maharjanalvik/ES1050-Winter-Project-2026-Lab-16-Pellets/Media/Pelletizer_with_electronics_enclosure.jpg

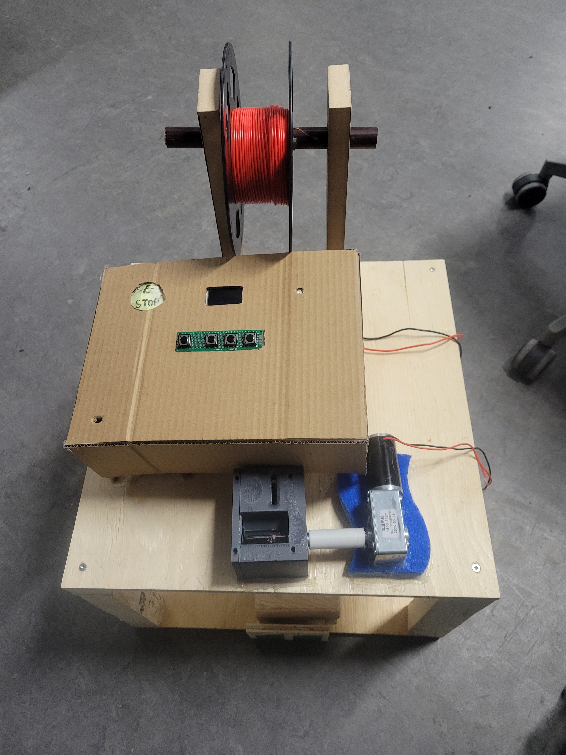
Media/Pelletizer_with_electronics_enclosure.jpg
