maharjanalvik/ES1050-Winter-Project-2026-Lab-16-Pellets/README.md

# Open-Source Recycled Plastic Pelletizer

A modular, open-source mechanical system designed to convert shredded plastic waste into uniform, high-quality pellets suitable for 3D printing and injection molding applications.

## Overview
This project is part of a larger closed-loop recycling workflow, enabling plastic waste to be processed into reusable material. The pelletizer focuses on consistency, reliability, and adaptability across different polymer types.

## Features
- **Open Source** Fully documented CAD models, technical drawings, and assembly instructions for easy replication and modification.

- **Modular Design** Components are designed for quick maintenance, repair, and upgrades without rebuilding the entire system.

- **Adjustable Processing** Supports variable speed and temperature control to accommodate a range of thermoplastics.

## Repository Structure
- `/CAD` → 3D models (STEP, STL) and technical drawings
- `/PelletizerFirmware` → Microcontroller firmware and control logic
- `/Electronics` → Wiring diagrams and circuit documentation
- `/Media` → Photos and videos of the system
- `BOM.csv` → Bill of Materials with sourcing link

## Getting Started
1. Review the **BOM.csv** to source required components  
2. Follow the assembly instructions in `/CAD` and `/Electronics`  
3. Upload firmware from `/Code` to the microcontroller  
4. Calibrate speed and temperature based on your material  

## Applications
- Pellet-based 3D printing  
- Injection molding  
- Plastic recycling research and prototyping  

## Acknowledgements
Developed for the FAST Lab at Western University under the supervision of Dr. Alessia Romani.  
Design inspiration referenced from [Teaching Tech](https://teachingtechyt.github.io/).
