maharjanalvik/ES1050-Winter-Project-2026-Lab-16-Pellets/Electronics/Block Diagram.png

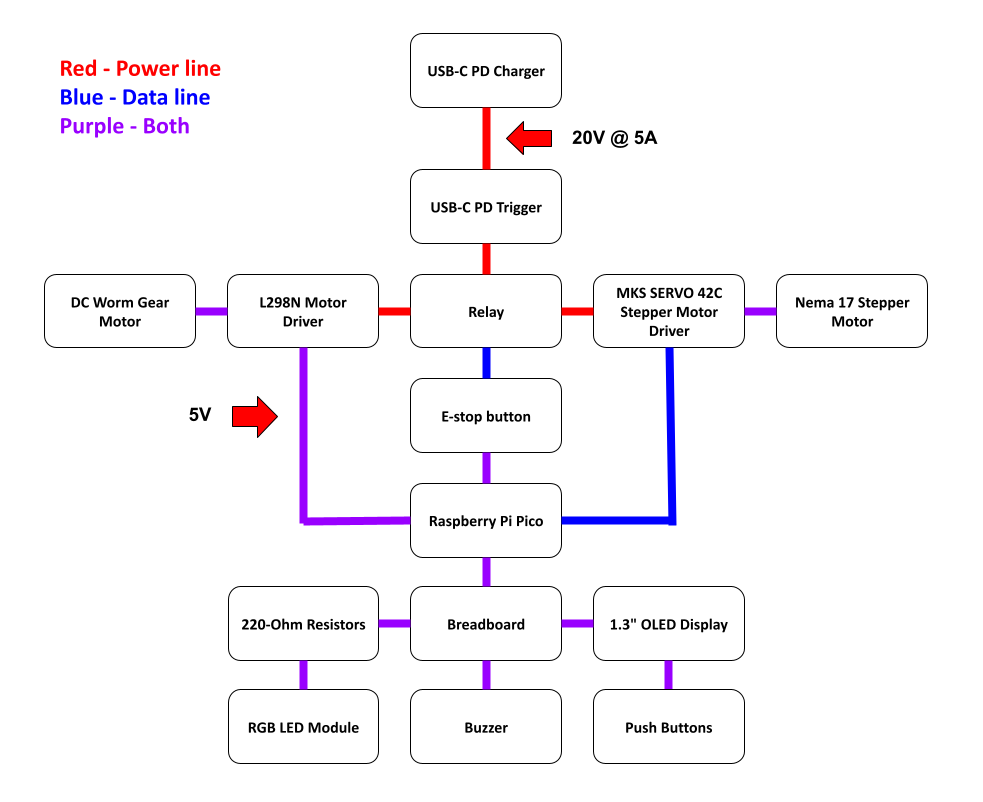
Electronics/Block Diagram.png
