maharjanalvik/ES1050-Winter-Project-2026-Lab-16-Pellets/Electronics/Schematic.png

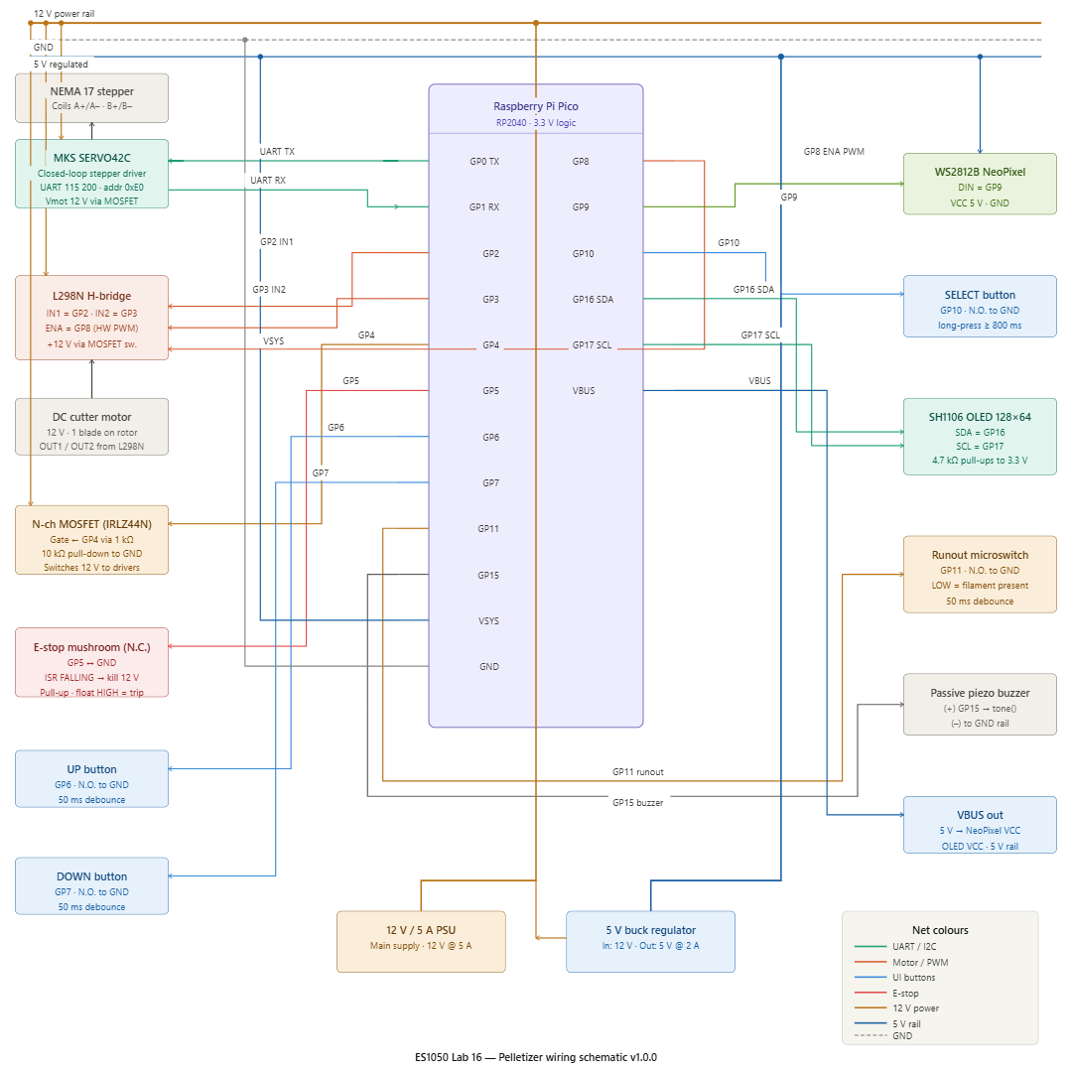
Electronics/Schematic.png
