maharjanalvik/ES1050-Winter-Project-2026-Lab-16-Pellets/Media/Sample_cut_pellets.jpg

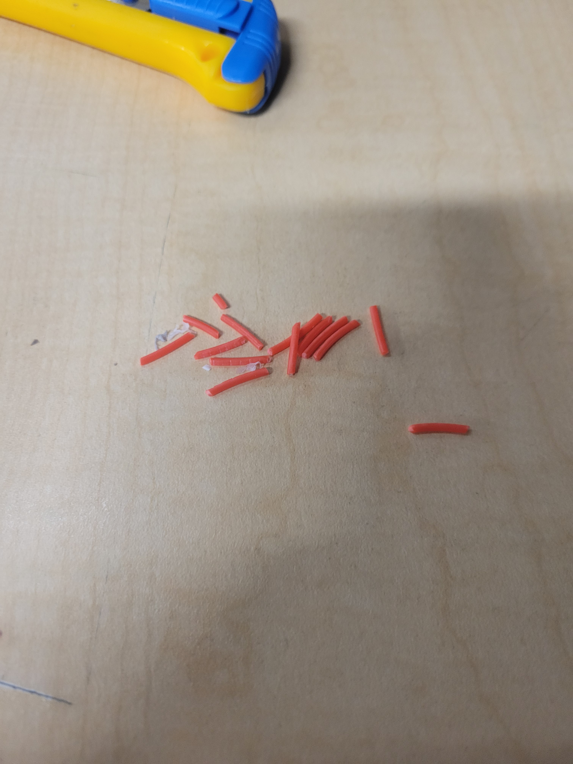
Media/Sample_cut_pellets.jpg
