maharjanalvik/ES1050-Winter-Project-2026-Lab-16-Pellets/CAD/Pelletizer enclosure.stp

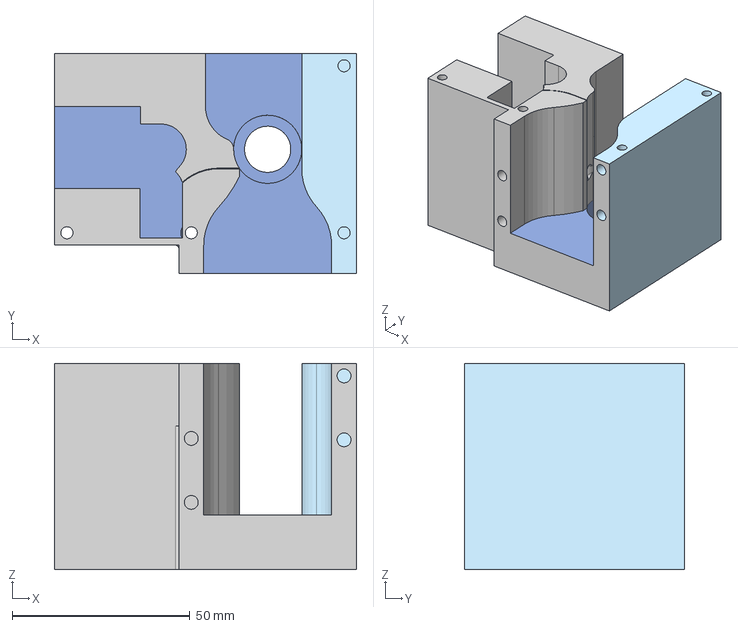
[picture p6: CAD file, 2026-04-11]
CAD/Pelletizer enclosure.stp
85.0 x 62.0 x 58.0 mm
