maharjanalvik/ES1050-Winter-Project-2026-Lab-16-Pellets/CAD/Coupler.step

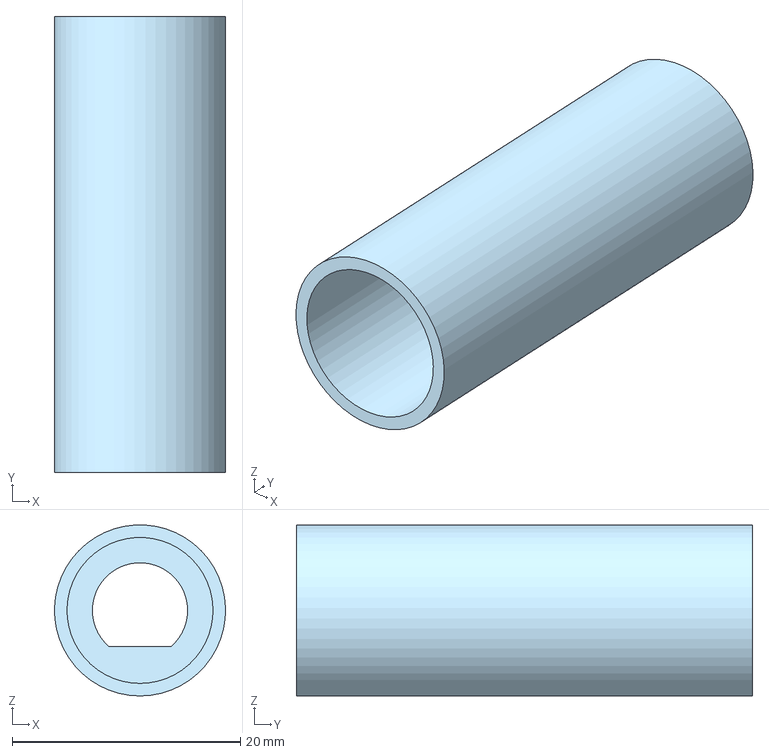
[picture p7: CAD file, 2026-04-11]
CAD/Coupler.step
15.0 x 40.0 x 15.0 mm
