maharjanalvik/ES1050-Winter-Project-2026-Lab-16-Pellets/CAD/electronics_box.stp

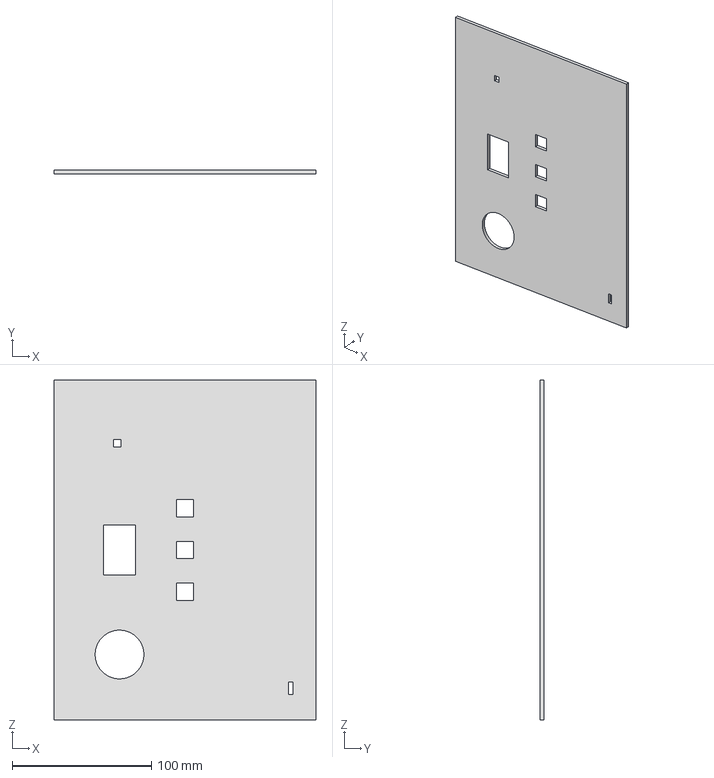
[picture p8: CAD file, 2026-04-11]
CAD/electronics_box.stp
188.0 x 3.00 x 244.0 mm
