maharjanalvik/ES1050-Winter-Project-2026-Lab-16-Pellets/(commit log)

2026-04-09 Create Circuit Block Diagram
2026-04-11 Rename pelletizer_schematic_fixed (2).png to Schematic.png
2026-04-11 Create cad
2026-04-11 Rename working_assembly_i_hope_YES.stp to Chopper enclosure.stp
    [Chopper enclosure.stp]
2026-04-11 Rename Chopper enclosure.stp to Pelletizer enclosure.stp
    [Pelletizer enclosure.stp]
